liakhovitch/junior_design/README.md

# Digital Kitchen Timer
A project for ECE341 (Junior Design) class by Anton Liakhovitch

The system is based around an STM32f103 microcontoller.
Firmware is written in Rust, using the stm32f1xx_hal library and RTIC concurrency framework.

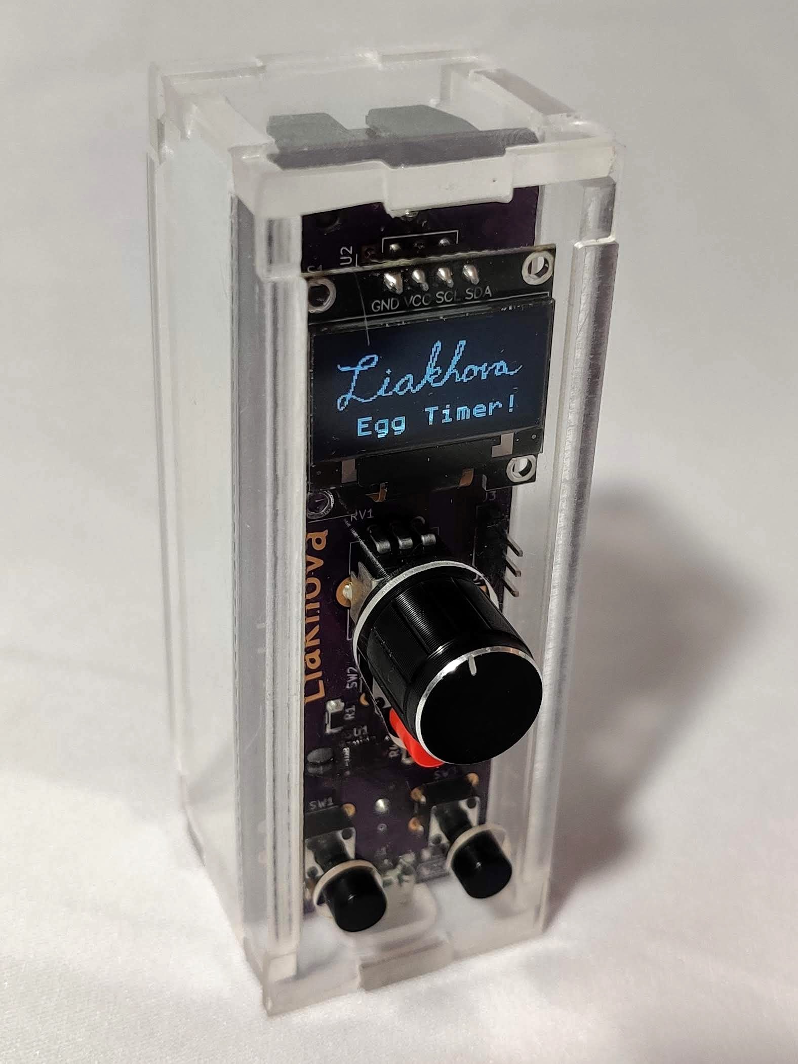
[picture p1: misc/diagonal.jpg]
Perspective view


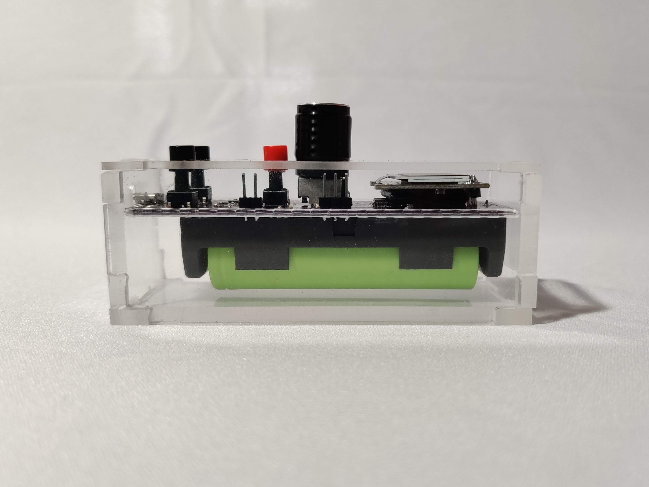
[picture p2: misc/side.jpg]
Side view


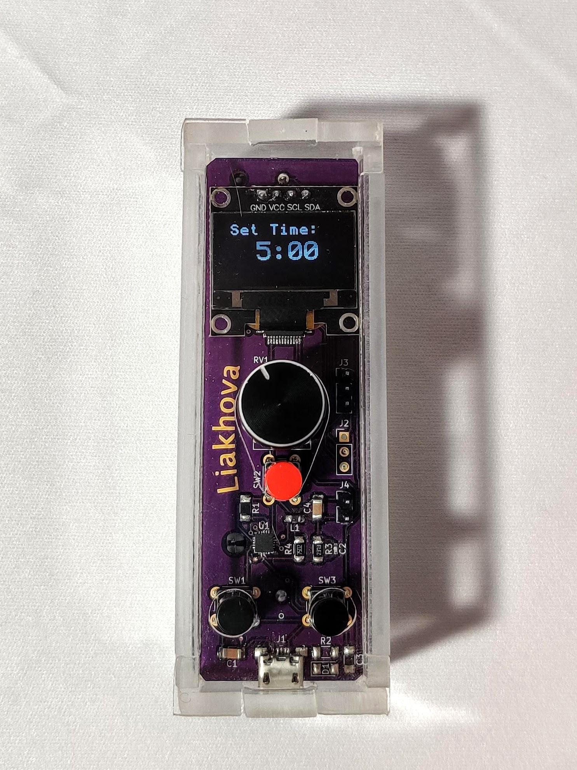
[picture p3: misc/front.jpg]
Front view


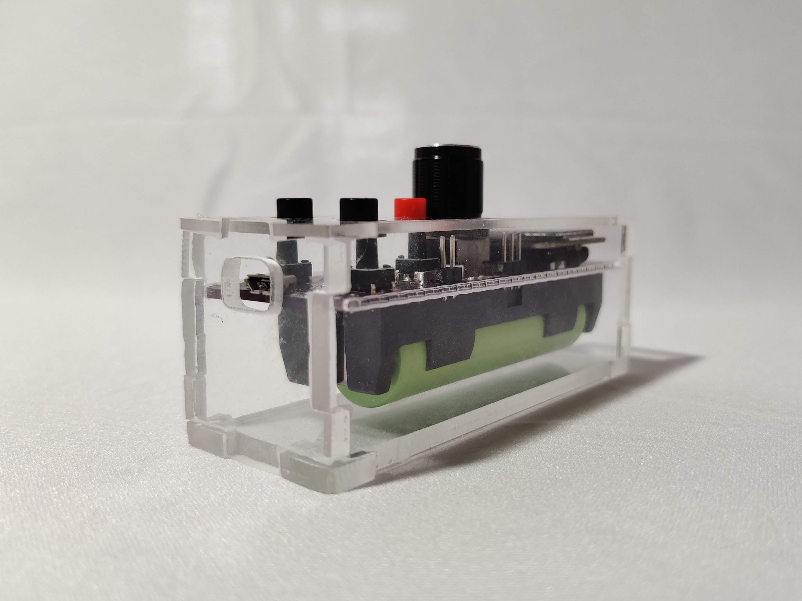
[picture p4: misc/bottom.jpg]
Bottom view
