liakhovitch/junior_design/case/case.FCStd

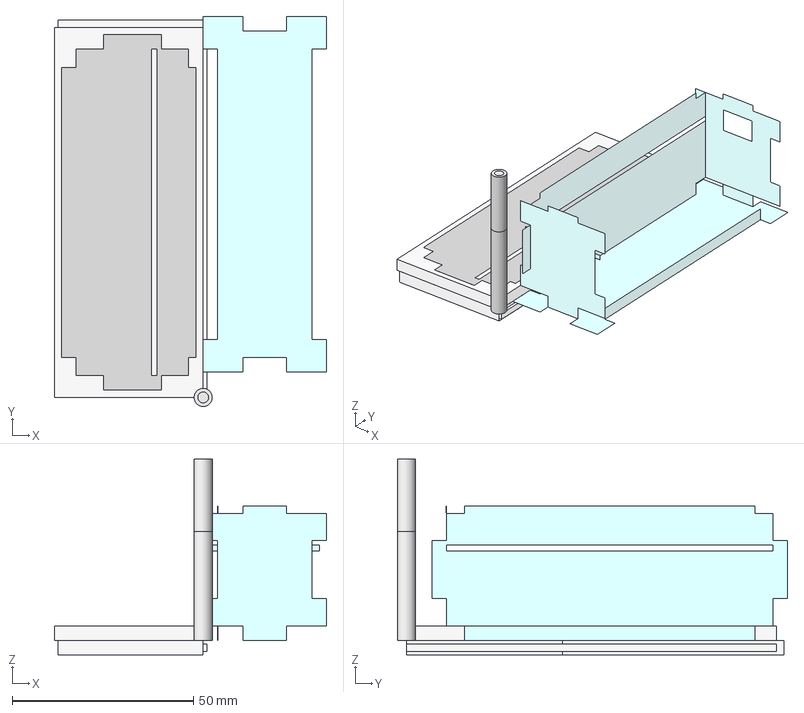
[picture p5: CAD file, 2021-06-01]
case/case.FCStd
75.0 x 107.5 x 54.0 mm
Model-Front
Model-Right
Model-Bottom
Model-Back
Stock
Stock002
Stock004
Stock006
Endmill
Endmill003
5mm Drill
Endmill006
5mm Drill001
1mm_mill
Endmill007
1mm_mill002
2-2_wtf
2-2_wtf002
_Element
_Element001
_Element002
_Element005
_Element006
_Element011
_Element020
_Element023
_Element034
_Element035
