liakhovitch/junior_design/pcb/jd_timer/jd_timer.kicad_pcb

## KiCad design pcb/jd_timer/jd_timer.kicad_pcb (2021-05-12)

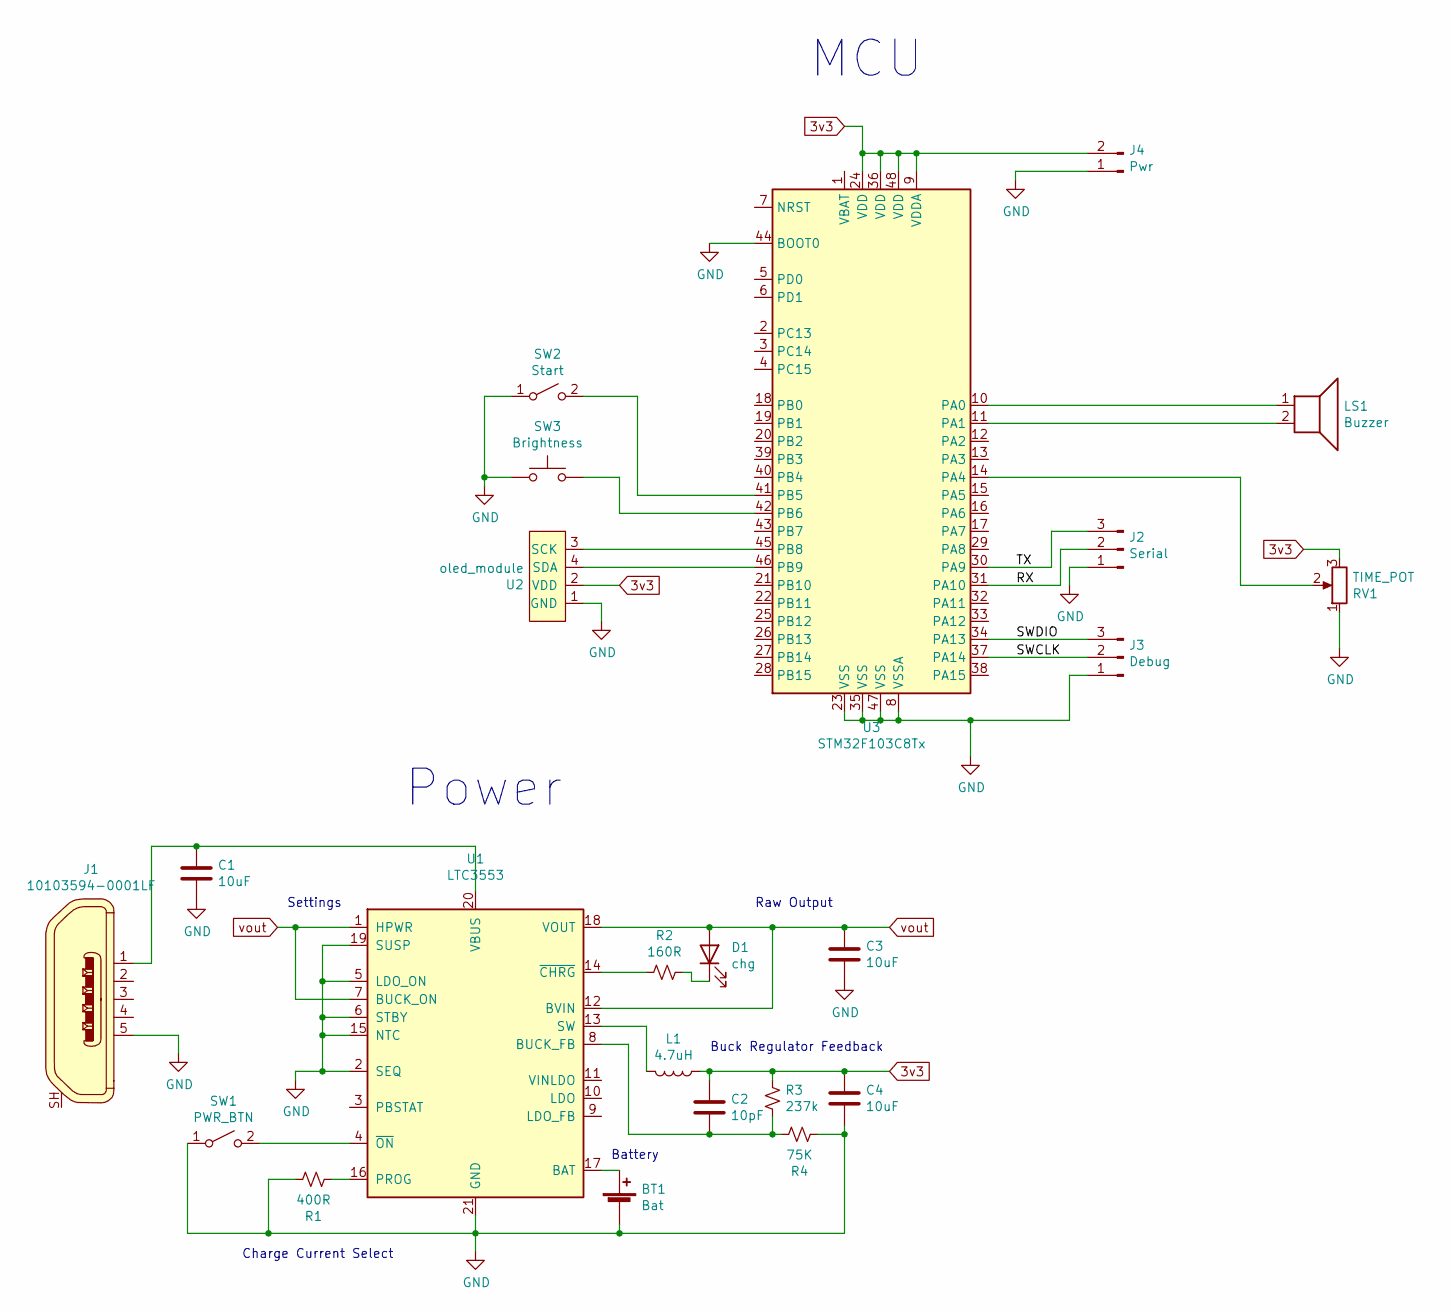
[picture p6: schematic jd_timer.sch, Egg Timer]

Parts:
BT1: Bat; 1043
C1, C3, C4: 10uF; C_1206_3216Metric_Pad1.33x1.80mm_HandSolder
C2: 10pF; C_0402_1005Metric_Pad0.74x0.62mm_HandSolder
D1: chg; LED_1206_3216Metric_Pad1.42x1.75mm_HandSolder
J1: 10103594-0001LF; USB_Micro_B_Female_10103594-0001LF; MPN 10103594-0001LF; Digi-Key_PN 609-4050-1-ND
J2: Serial; PinHeader_1x03_P2.54mm_Vertical
J3: Debug; PinHeader_1x03_P2.54mm_Vertical
J4: Pwr; PinHeader_1x02_P2.54mm_Vertical
L1: 4.7uH; L_0805_2012Metric_Pad1.05x1.20mm_HandSolder
LS1: Buzzer; PKLCS1212E2000-R1
R1: 400R; R_1206_3216Metric_Pad1.30x1.75mm_HandSolder
R2: 160R; R_1206_3216Metric_Pad1.30x1.75mm_HandSolder
R3: 237k; R_1206_3216Metric_Pad1.30x1.75mm_HandSolder
R4: 75K; R_1206_3216Metric_Pad1.30x1.75mm_HandSolder
RV1: TIME_POT; Potentiometer_Bourns_PTV09A-1_Single_Vertical
SW1: PWR_BTN; SW_PUSH_6mm_H13mm
SW2: Start; SW_PUSH_6mm_H13mm
SW3: Brightness; SW_PUSH_6mm_H13mm
U1: LTC3553; QFN-20-1EP_3x3mm_P0.4mm_EP1.65x1.65mm
U2: oled_module; PinHeader_1x04_P2.54mm_Vertical
U3: STM32F103C8Tx; LQFP-48_7x7mm_P0.5mm

Connections:
3v3: C2.1, C4.1, J4.2, L1.1, R3.1, RV1.3, U2.2 (VDD), U3.9 (VDDA), U3.24 (VDD), U3.36 (VDD), U3.48 (VDD)
/RX: J2.2, U3.31 (PA10)
/SWCLK: J3.2, U3.37 (PA14)
/SWDIO: J3.3, U3.34 (PA13)
/TX: J2.3, U3.30 (PA9)
GND: BT1.2 (-), C1.2, C3.2, C4.2, J1.5, J2.1, J3.1, J4.1, R1.1, R4.2, RV1.1, SW1.1 (A), SW2.1 (A), SW3.1, U1.2 (SEQ), U1.5 (LDO_ON), U1.6 (STBY), U1.15 (NTC), U1.19 (SUSP), U1.21 (GND), U2.1 (GND), U3.8 (VSSA), U3.23 (VSS), U3.35 (VSS), U3.44 (BOOT0), U3.47 (VSS)
unnamed: BT1.1 (+), U1.17 (BAT)
unnamed: C1.1, J1.1, U1.20 (VBUS)
unnamed: C2.2, R3.2, R4.1, U1.8 (BUCK_FB)
unnamed: D1.1 (K), R2.1
unnamed: L1.2, U1.13 (SW)
unnamed: LS1.1, U3.10 (PA0)
unnamed: LS1.2, U3.11 (PA1)
unnamed: R1.2, U1.16 (PROG)
unnamed: R2.2, U1.14 (~CHRG~)
unnamed: RV1.2, U3.14 (PA4)
unnamed: SW1.2 (B), U1.4 (~ON~)
unnamed: SW2.2 (B), U3.41 (PB5)
unnamed: SW3.2, U3.42 (PB6)
unnamed: U2.3 (SCK), U3.45 (PB8)
unnamed: U2.4 (SDA), U3.46 (PB9)
vout: C3.1, D1.2 (A), U1.1 (HPWR), U1.7 (BUCK_ON), U1.12 (BVIN), U1.18 (VOUT)

Notes on the sheet:
MCU
Charge Current Select
Battery
Raw Output
Buck Regulator Feedback
Settings
Power

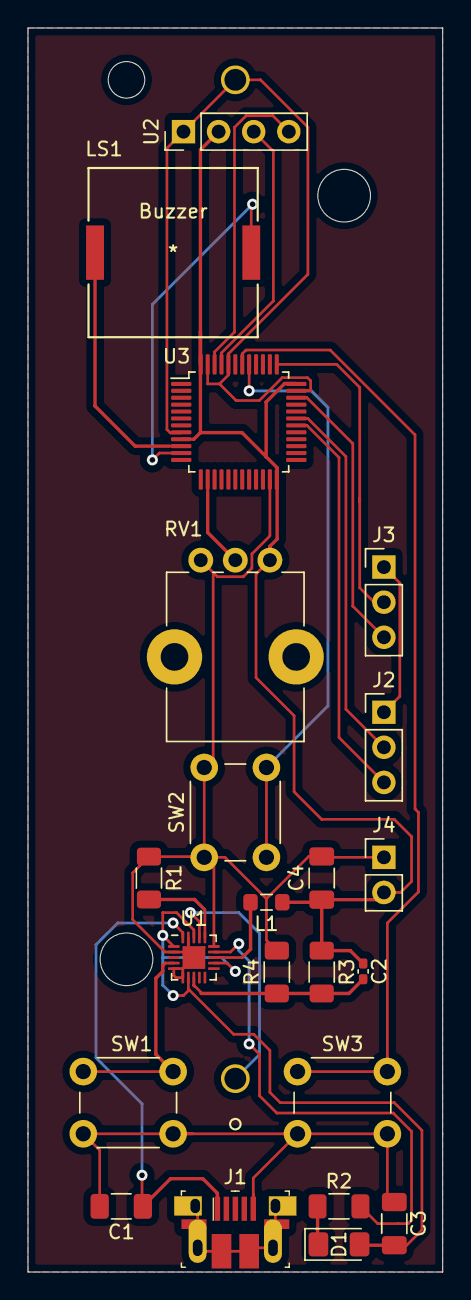
[picture p7: board jd_timer.kicad_pcb from above]

Board: 2 copper layers, 30.0 x 90.0 mm, 23 parts (1 on the bottom side), 22 nets.
