liakhovitch/junior_design/src/jd_timer/src/main.rs

#![no_std]
#![no_main]
#![allow(unused_imports)]

use panic_halt as _;

// Declare modules for the other parts of the project.
// Rust automatically matches these by filename and creates the proper scopes.
mod buttons;
mod pot;
mod ui;
mod rtc;
mod beep;
mod types;
mod config;
mod states;
mod rtc_util;
mod charge;
#[path = "./bitmaps/bigbolt.rs"]
mod bigbolt;
#[path = "./bitmaps/smallbolt.rs"]
mod smallbolt;
#[path = "./bitmaps/logo.rs"]
mod logo;

#[rtic::app(device = stm32f1xx_hal::pac,
peripherals = true, dispatchers = [DMA1_CHANNEL1,DMA1_CHANNEL2,DMA1_CHANNEL3])]
// RTIC application
mod app {

    // Include other parts of the project so the task definitions at the bottom can access them
    use crate::buttons::*;
    use crate::pot::*;
    use crate::ui::*;
    use crate::types::*;
    use crate::beep::*;
    use crate::rtc::*;
    use crate::states::*;
    use crate::charge::*;
    // My modified version of the stm32f1xx_hal RTC library
    use crate::rtc_util;

    use crate::config::{SLEEP_TIME};

    use stm32f1xx_hal::{
        adc::{Adc, SampleTime},
        prelude::*,
        serial,
        gpio::{
            gpiob::{PB8, PB9, PB6, PB5},
            gpioa::{PA0, PA1, PA4, PA9, PA10},
            {Output, PushPull},
            {Input, PullUp},
            {Alternate, OpenDrain},
            Edge::*,
            ExtiPin,
            Analog,
        },
        timer::{Event, Timer, Tim2NoRemap},
        pac::{I2C1, USART1, ADC1, TIM2},
        i2c::{BlockingI2c, DutyCycle, Mode},
        pwm::C1,
        rtc::Rtc,
    };

    use dwt_systick_monotonic::DwtSystick;

    use cortex_m::asm::delay;

    //use core::fmt::Write;
    use ssd1306::{
        prelude::*,
        Builder,
        I2CDIBuilder,
    };

    use embedded_graphics::{
        fonts::Text,
        pixelcolor::BinaryColor,
        prelude::*,
        style::TextStyle,
    };

    use profont::ProFont24Point;

    // Import peripheral control methods from general HAL definition
    use embedded_hal::digital::v2::{OutputPin, InputPin};

    use core::fmt::Write;
    use core::future::Future;
    use core::ptr::*;
    use rtic::rtic_monotonic::{Clock, Milliseconds, Nanoseconds};
    use embedded_time::duration::*;
    use core::convert::TryFrom;
    use rtic::rtic_monotonic::embedded_time::fixed_point::FixedPoint;
    use rtic::Monotonic;

    // Declare type for monotonic timer used by RTIC for task scheduling
    #[monotonic(binds = SysTick, default = true)]
    type MyMono = DwtSystick<8_000_000>; // 8 MHz

    // Resources shared by all handlers.
    // All resourced not initialized here by macros are initialized in [init] and returned to RTIC
    //   in the init::LateResources object.
    #[resources]
    struct Resources {
        display: GraphicsMode<I2CInterface<BlockingI2c<I2C1, (PB8<Alternate<OpenDrain>>,PB9<Alternate<OpenDrain>>) >>, DisplaySize128x64>,
        button_start: PB5<Input<PullUp>>,
        button_brightness: PB6<Input<PullUp>>,
        chg_pin: PA10<Input<PullUp>>,
        EXTI: stm32f1xx_hal::pac::EXTI,
        clocks: stm32f1xx_hal::rcc::Clocks,
        adc1: Adc<ADC1>,
        pot: PA4<Analog>,
        pot_pos: u16,
        sleep_pin: PA9<Output<PushPull>>,
        buzzer: stm32f1xx_hal::pwm::PwmChannel<TIM2, C1>,
        rtc: stm32f1xx_hal::pac::RTC,
        #[init(0)]
        brightness_state: u8,
        #[init(false)]
        pot_dir: bool,
        #[init(SysState::Setup)]
        sys_state: SysState,
        #[init(0)]
        max_time: u16,
        #[init(0)]
        time_remaining: u16,
        #[init(0)]
        disp_call_cnt: u8,
    }

    // Init function
    #[init ()]
    // CX object contains our PAC (peripheral access crate)
    // Init function initializes resources and returns them to RTIC via the LateResources object.
    fn init(cx: init::Context) -> (init::LateResources,init::Monotonics){

// -------------
// General Setup
// -------------

        // Enable cycle counter
        let mut core = cx.core;
        core.DWT.enable_cycle_counter();
        // Take ownership of clock register
        let mut rcc = cx.device.RCC.constrain();
        // Take ownership of flash peripheral
        let mut flash = cx.device.FLASH.constrain();
        // Take ownership of AFIO register
        let mut afio = cx.device.AFIO.constrain(&mut rcc.apb2);

        // Configure clocks and make clock object from clock register
        let clocks = rcc
            .cfgr
            //.use_hse(8.mhz())
            //.sysclk(8.mhz())
            //.pclk1(4.mhz())
            .freeze(&mut flash.acr);

        // Split GPIO ports into smaller pin objects
        let mut gpioa = cx.device.GPIOA.split(&mut rcc.apb2);
        let mut gpiob = cx.device.GPIOB.split(&mut rcc.apb2);

// ---------------------
// Init scheduling timer
// ---------------------
        // This monotonic timer object is returned to the RTIC framework for use in task scheduling
        let mut mono = DwtSystick::new(&mut core.DCB, core.DWT, core.SYST, 8_000_000);
        unsafe {
            mono.reset();
            mono.enable_timer();
        }

// --------
// Init RTC
// --------
        let mut rtc = cx.device.RTC;

        // We start by modifying some registers that the HAL already has control of,
        // behind the HAL's back, using unsafe code. We can do this with safe code before
        // initializing the HAL, but we have no guarantee that HAL initialization won't
        // overwrite our changes. For reference, this is what that might have looked like:
        //cx.device.RCC.apb1enr.modify(|_,w| w.pwren().set_bit().bkpen().set_bit());
        //cx.device.RCC.csr.modify(|_,w| w.lsion().set_bit());
        unsafe {
            // Get address of PWR register block
            // Note: PWR access can actually be done safely, but we need the volatile write to
            // ensure that the compiler doesn't put this after our attempts to write to RCC_BDCR.
            let pwr_ptr: *mut u32 = stm32f1xx_hal::pac::PWR::ptr() as *mut u32;

            // Get address of RCC register block
            let rcc_ptr: *mut u32 = stm32f1xx_hal::pac::RCC::ptr() as *mut u32;

            // Offset to get apb1enr address
            // Offset is: 0x1C bytes (from datasheet) / 4 = 7 words
            let apb1enr_ptr: *mut u32 = rcc_ptr.offset(7);
            // Get current reg value
            let mut apb1enr_temp: u32 = read_volatile(apb1enr_ptr);
            // Set BKPEN: Enable backup domain access
            apb1enr_temp |= 1<<27;
            // Set PWREN: Enable backup domain access even harder
            apb1enr_temp |= 1<<28;
            // Write changes
            write_volatile(apb1enr_ptr, apb1enr_temp);

            // Offset to get RCC_CSR address
            // Offset is: 0x24 bytes (from datasheet) / 4 = 9 words
            let rcc_csr_ptr: *mut u32 = rcc_ptr.offset(9);
            // Get current reg value
            let mut rcc_csr_temp: u32 = read_volatile(rcc_csr_ptr);
            // Set LSION: Turn on low speed internal oscillator
            rcc_csr_temp |= 1<<0;
            // Write changes
            write_volatile(rcc_csr_ptr, rcc_csr_temp);

            // Offset to get pwr_cr address
            // Offset is: 0x00 bytes (from datasheet) / 4 = 0 words
            let pwr_cr_ptr: *mut u32 = pwr_ptr.offset(0);
            // Get current reg value
            let mut pwr_cr_temp: u32 = read_volatile(pwr_cr_ptr);
            // Set DBP: Disable backup domain write protection
            pwr_cr_temp |= 1<<8;
            // Write changes
            write_volatile(pwr_cr_ptr, pwr_cr_temp);

            // Offset to get RCC_BDCR address
            // Offset is: 0x20 bytes (from datasheet) / 4 = 8 words
            let rcc_bdcr_ptr: *mut u32 = rcc_ptr.offset(8);
            // Get current reg value
            let mut rcc_bdcr_temp: u32 = read_volatile(rcc_bdcr_ptr);
            // Set RTCEN: Enable RTC
            rcc_bdcr_temp |= 1<<15;
            // Set RTCSEL: Set RTC clock source to LSI (Low Speed Internal) clock
            rcc_bdcr_temp |= 0b10<<8;
            // Write changes
            write_volatile(rcc_bdcr_ptr, rcc_bdcr_temp);
        }

// -------------
// Calibrate RTC
// -------------

        // Procedure:
        //  * Set the RTC prescaler such that one tick takes about 0.25s
        //  * Use the system clock to measure how long that tick takes
        //  * Set the -correct- prescaler based on that data
        // The datasheet recommends a hardware-based method not available on this particular chip,
        //   so I had to improvise.

        // We will spend 1/CAL_DIV seconds on calibration
        const CAL_DIV:u32 = 4;
        // Conversion factor from time measurement units to seconds
        const CONV_FACTOR:u32 = 1_000_000_000;
        // Initial guess as to the LSI (Low Speed Internal oscillator) frequency
        const LSI_GUESS:u32 = 40_000;

        // Set RTC prescaler. Code partly borrowed from the HAL.
        let prescaler = (LSI_GUESS / CAL_DIV) - 1;
        rtc_util::rtc_write(&mut rtc, |rtc| {
            rtc.prlh.write(|w| unsafe { w.bits(prescaler >> 16) });
            rtc.prll.write(|w| unsafe { w.bits(prescaler as u16 as u32) });
        });

        // Reset the RTC counter
        // This is done before the clock starts to compensate for the RTC read operation done after
        // the clock starts. Both operations take around three RTC clock cycles, which is a lot of
        // system cycles.
        rtc_util::set_time(&mut rtc, 0);

        // Measure initial time
        // Welcome to the wonderful world of embedded Rust!
        let time_start = *(Nanoseconds::<u32>::try_from(
            mono.try_now().unwrap().duration_since_epoch()
        ).unwrap().integer());

        // Blocking wait until RTC ticks
        while rtc_util::current_time(&mut rtc) == 0 {};

        // Measure final time
        let time_stop = *(Nanoseconds::<u32>::try_from(
            mono.try_now().unwrap().duration_since_epoch()
        ).unwrap().integer());

        // This is the amount of time it takes the LSI to tick 10_000 times
        let time_diff = time_stop - time_start;

        // Calculate the correct frequency
        // To do this without FP, we order operations such that numbers get BIG before they get
        //   small again. Hence, conversion to u64 and then conversion back into u32.
        let lsi_hz:u32 = (
            (((LSI_GUESS / CAL_DIV) as u64) * (CONV_FACTOR as u64))
            / (time_diff as u64)
        ) as u32;

        // Set RTC prescaler. Code partly borrowed from the HAL.
        let prescaler = (lsi_hz) - 1;
        rtc_util::rtc_write(&mut rtc, |rtc| {
            rtc.prlh.write(|w| unsafe { w.bits(prescaler >> 16) });
            rtc.prll.write(|w| unsafe { w.bits(prescaler as u16 as u32) });
        });

// ---------
// Setup RTC
// ---------

        rtc_util::set_time(&mut rtc, 0);
        rtc_util::unlisten_alarm(&mut rtc);
        rtc_util::listen_seconds(&mut rtc);
        rtc_util::clear_alarm_flag(&mut rtc);
        rtc_util::clear_second_flag(&mut rtc);

// -----------
// Init buttons
// -----------
        // Start timer button
        let mut button_start = gpiob.pb5.into_pull_up_input(&mut gpiob.crl);
        button_start.make_interrupt_source(&mut afio);
        button_start.trigger_on_edge(&cx.device.EXTI, FALLING);
        button_start.enable_interrupt(&cx.device.EXTI);
        // Brightness button
        let mut button_brightness = gpiob.pb6.into_pull_up_input(&mut gpiob.crl);
        button_brightness.make_interrupt_source(&mut afio);
        button_brightness.trigger_on_edge(&cx.device.EXTI, FALLING);
        button_brightness.enable_interrupt(&cx.device.EXTI);
        // Note: Both buttons trigger the EXTI9_5 interrupt.

// ------------
// Init pot adc
// ------------
        // Setup adc1 with default settings
        let mut adc1 = Adc::adc1(cx.device.ADC1, &mut rcc.apb2, clocks);
        adc1.set_sample_time(SampleTime::T_239);
        // Setup PA4 as analog input
        let mut pot = gpioa.pa4.into_analog(&mut gpioa.crl);
        // Take initial read
        let mut pot_pos = adc1.read(&mut pot).unwrap();
        pot_pos = pot_pos >> 4;

// -----------------
// Init PMIC control
// -----------------
        let mut sleep_pin = gpioa.pa9.into_push_pull_output(&mut gpioa.crh);
        // Tell the PMIC to please not shut us off
        sleep_pin.set_high().unwrap();

// ------------------
// Init PMIC feedback
// ------------------
        let mut chg_pin = gpioa.pa10.into_pull_up_input(&mut gpioa.crh);
        chg_pin.make_interrupt_source(&mut afio);
        chg_pin.trigger_on_edge(&cx.device.EXTI, RISING_FALLING);
        chg_pin.enable_interrupt(&cx.device.EXTI);
        // This will use interrupt EXTI15_10

// ------------
// Init buzzer
// ------------
        // For now, only using PWM on one pin
        // Polarity flipping for individual timer channels not yet supported by HAL
        let buzz0 = gpioa.pa0.into_alternate_push_pull(&mut gpioa.crl);
        let mut buzz1 = gpioa.pa1.into_push_pull_output(&mut gpioa.crl);
        buzz1.set_low().unwrap();
        let mut buzzer = Timer::tim2(cx.device.TIM2, &clocks, &mut rcc.apb1)
            .pwm::<Tim2NoRemap, _, _, _>(buzz0, &mut afio.mapr, 440.hz()).split();
        buzzer.set_duty(buzzer.get_max_duty() / 2);

// ----------------
// Init I2C display
// ----------------
        // Init IO pins
        let scl = gpiob.pb8.into_alternate_open_drain(&mut gpiob.crh);
        let sda = gpiob.pb9.into_alternate_open_drain(&mut gpiob.crh);

        // Init i2c peripheral
        let i2c = BlockingI2c::i2c1(
            cx.device.I2C1,
            (scl, sda),
            &mut afio.mapr,
            Mode::Fast {
                frequency: 400_000.hz(),
                duty_cycle: DutyCycle::Ratio2to1,
            },
            clocks,
            &mut rcc.apb1,
            1000,
            10,
            1000,
            1000,
        );

        // Init i2c interface
        let interface = I2CDIBuilder::new().init(i2c);
        // Create display in graphics mode (as opposed to terminal mode)
        let mut display: GraphicsMode<_, _> = Builder::new().connect(interface).into();
        // Init display
        display.init().unwrap();
        display.clear();
        display.flush().unwrap();

// ------------------
// Start bootup tasks
// ------------------

        // Read initial ADC value
        let _ = handle_adc::spawn(true);
        // Do startup beep
        let _ = beep::spawn(70, 2);
        // Show boot message
        let _ = update_display::spawn(ScreenPage::Boot);

        // Return initialized resources to RTIC so they can be loaned to tasks
        (init::LateResources {
            display,
            button_start, button_brightness,
            chg_pin,
            EXTI: cx.device.EXTI,
            clocks,
            adc1,
            pot,
            pot_pos,
            sleep_pin,
            buzzer,
            rtc,
        },
         // Return timer object so RTIC can use it for task scheduling.
         init::Monotonics(mono))
    }

    // Idle task, run when nothing else is happening. This is where polling happens.
    #[idle(resources = [sys_state])]
    fn idle(cx: idle::Context) -> ! {
        let mut sys_state = cx.resources.sys_state;
        loop {
            // Read off the ADC value
            sys_state.lock(|sys_state| {
                if *sys_state != SysState::Timer {
                    let _ = handle_adc::spawn(false);
                }
            });
        }
    }

    // This is where we declare tasks which are in external files.
    // 'binds' specifies interrupts the task is bound to
    // 'resources' specify global resource permissions
    // 'priority' decides which tasks can preempt each other
    extern "Rust" {
        #[task(binds = EXTI9_5, resources = [&clocks, button_start, button_brightness, EXTI, display, brightness_state, sys_state], priority=1)]
        fn handle_buttons(cx: handle_buttons::Context);
        #[task(binds = EXTI15_10, resources = [chg_pin, disp_call_cnt], priority=1)]
        fn handle_charge(cx: handle_charge::Context);
        #[task(resources = [pot, pot_pos, adc1, pot_dir, max_time], priority=1)]
        fn handle_adc(cx: handle_adc::Context, silent:bool);
        #[task(resources = [rtc, display, max_time, brightness_state, disp_call_cnt, chg_pin], priority=1, capacity=3)]
        fn update_display(cx: update_display::Context, screen_type:ScreenPage);
        #[task(resources = [disp_call_cnt, sys_state], priority=1, capacity=10)]
        fn reset_display(cx: reset_display::Context);
        #[task(resources = [buzzer], priority=2, capacity=1)]
        fn beep(cx: beep::Context, length: u32, count: u8);
        #[task(resources = [buzzer], priority=2, capacity=1)]
        fn unbeep(cx: unbeep::Context, length: u32, count: u8);
        #[task(binds = RTC, resources = [rtc, sys_state, max_time, disp_call_cnt, chg_pin], priority=2)]
        fn tick(cx: tick::Context);
        #[task(resources = [rtc, sys_state], priority=3, capacity=1)]
        fn kick_dog(cx: kick_dog::Context);
        #[task(resources = [rtc, sys_state, sleep_pin, max_time, disp_call_cnt], priority=1, capacity=1)]
        fn to_state(cx: to_state::Context, target: SysState);
    }
}
