liakhovitch/junior_design/src/jd_timer/src/config.rs

// General configuration file for defining constants that might need tweaking.

// Maximum time user can set on the timer
pub const MAX_TIME: u16 = 900;
// Time steps to increment time by
pub const TIME_STEPS: u16 = 15;
// Time it takes to cook a soft-boiled egg
pub const SOFT_BOILED: u16 = 240;
// Time it takes to cook a hard-boiled egg
pub const HARD_BOILED: u16 = 600;
// Sleep timeout
pub const SLEEP_TIME: u16 = 30;
