liakhovitch/junior_design/(commit log)

2021-05-12 Finished PCB
    [jd_timer.kicad_pcb, jd_timer.sch]
2021-05-12 Init Rust project for jd timer
2021-05-12 Setup buttons (with interrupts) and ADC
2021-05-23 Added state switch task
2021-05-23 About to screw up some stuff
2021-05-25 Got application mostly working. Todo: fix remaining bugs and add rtc calibration.
    [main.rs, rtc.rs, rtc_util.rs, states.rs, types.rs, ui.rs]
2021-05-26 Fixed bugs. Todo: RTC calibration
    [main.rs, rtc.rs]
2021-05-26 Added RTC calibration
2021-05-26 Fixed some bugs and improved documentation
    [beep.rs, buttons.rs, config.rs, logo.rs, main.rs, pot.rs, rtc_util.rs, states.rs]
2021-05-27 Added charging indicator
2021-06-01 Added gitignore and CAD files
    [case.FCStd]
